rapexa/kmtouch/hardware/netlist.txt

# kmtouch v1 netlist, pin-level (generated from kicad/kmtouch.kicad_pcb; source of truth = kicad/kmtouch.kicad_sch)
+1V1: C11.1 C12.1 C13.1 U1.23 U1.45 U1.50
+3V3: C10.1 C16.1 C3.1 C4.1 C5.1 C6.1 C7.1 C8.1 C9.1 R12.2 R7.2 R8.2 U1.1 U1.10 U1.22 U1.33 U1.42 U1.43 U1.44 U1.48 U1.49 U2.5 U3.8
+5V: C1.1 C19.1 C2.1 C21.1 F1.2 U2.1 U2.3 U5.5 U6.18 U6.20
5V_A: C20.1 J2.1 J3.1 U5.1 U7.5 U8.5
A1DM: J2.2 U6.10 U7.3 U7.4
A1DP: J2.3 U6.11 U7.1 U7.6
A2DM: J3.2 U6.8 U8.3 U8.4
A2DP: J3.3 U6.9 U8.1 U8.6
BOOT: R9.2 SW1.1
CC1: J1.A5 R1.1
CC2: J1.B5 R2.1
CDM: J1.A7 J1.B7 R4.1 U4.3 U4.4
CDP: J1.A6 J1.B6 R3.1 U4.1 U4.6
FLT: R12.1 U1.30 U5.3 U6.26
GND: C1.2 C10.2 C11.2 C12.2 C13.2 C14.2 C15.2 C16.2 C17.2 C18.2 C19.2 C2.2 C20.2 C21.2 C3.2 C4.2 C5.2 C6.2 C7.2 C8.2 C9.2 D1.1 J1.A1 J1.A12 J1.B1 J1.B12 J1.S1 J2.4 J2.5 J3.4 J3.5 R1.2 R13.2 R15.2 R2.2 SW1.2 SW2.2 TP3.1 U1.19 U1.57 U2.2 U3.4 U4.2 U5.2 U6.1 U7.2 U8.2 Y1.2 Y1.4 Y2.2 Y2.4
GP2: R5.1 U1.4
GP25: R11.1 U1.37
GP3: R6.1 U1.5
HRST: R14.1 U6.17
HUB_DM: R6.2 U6.15
HUB_DP: R5.2 U6.16
HXI: U6.3 Y2.1
HXO: U6.2 Y2.3
LED_A: D1.2 R11.2
QSPI_SCLK: U1.52 U3.6
QSPI_SD0: U1.53 U3.5
QSPI_SD1: U1.55 U3.2
QSPI_SD2: U1.54 U3.3
QSPI_SD3: U1.51 U3.7
QSPI_SS: R8.1 R9.1 U1.56 U3.1
REXT: R13.1 U6.14
RUN: R7.1 SW2.1 U1.26
SWCLK: TP1.1 U1.24
SWDIO: TP2.1 U1.25
USB_DM: R4.2 U1.46
USB_DP: R3.2 U1.47
VBUS: F1.1 J1.A4 J1.A9 J1.B4 J1.B9 U4.5
VBUS_EN: R15.1 U1.29 U5.4
VD33H: C17.1 C18.1 R14.2 U6.13 U6.19 U6.21
XIN: C14.1 U1.20 Y1.1
XO1: C15.1 R10.2 Y1.3
XOUT: R10.1 U1.21
