rapexa/kmtouch/hardware/kicad/out/render/kmtouch_2d_bottom.png

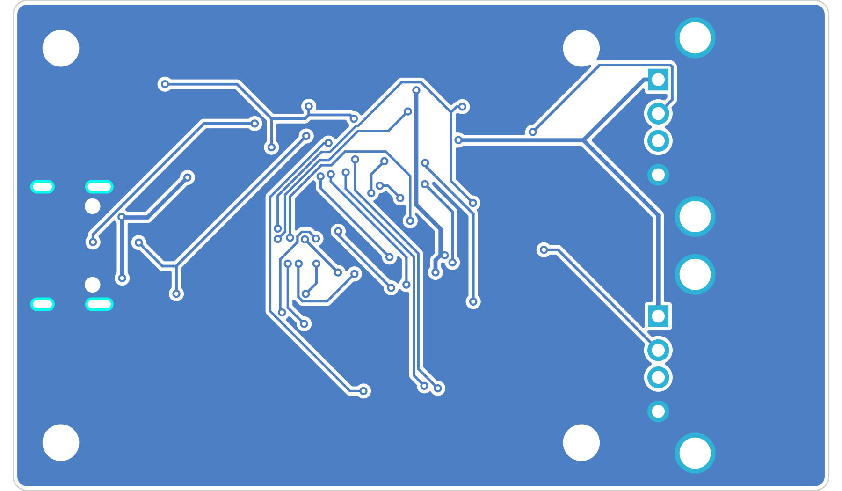
hardware/kicad/out/render/kmtouch_2d_bottom.png
