rapexa/kmtouch/hardware/kicad/out/render/kmtouch_3d_bottom.png

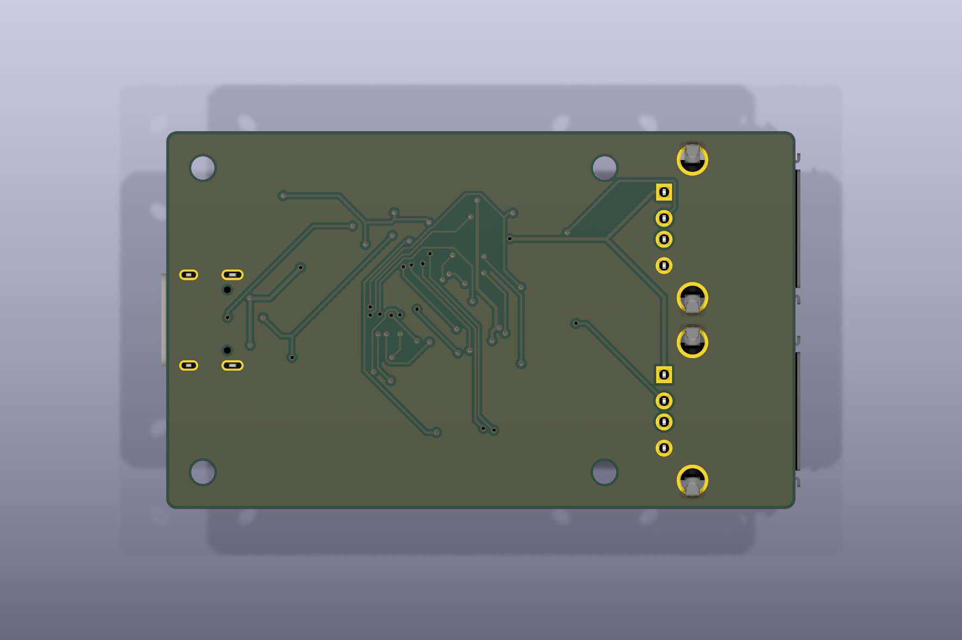
hardware/kicad/out/render/kmtouch_3d_bottom.png
