rapexa/kmtouch/hardware/kicad/out/render/kmtouch_3d_top.png

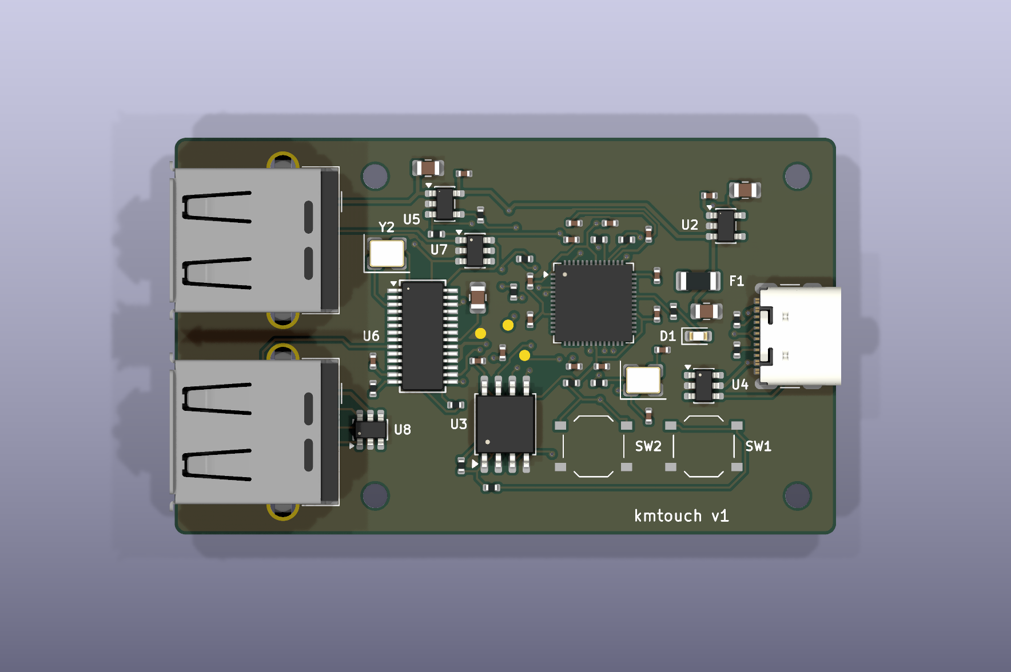
hardware/kicad/out/render/kmtouch_3d_top.png
