rapexa/kmtouch/hardware/kicad/out/render/kmtouch_schematic.png

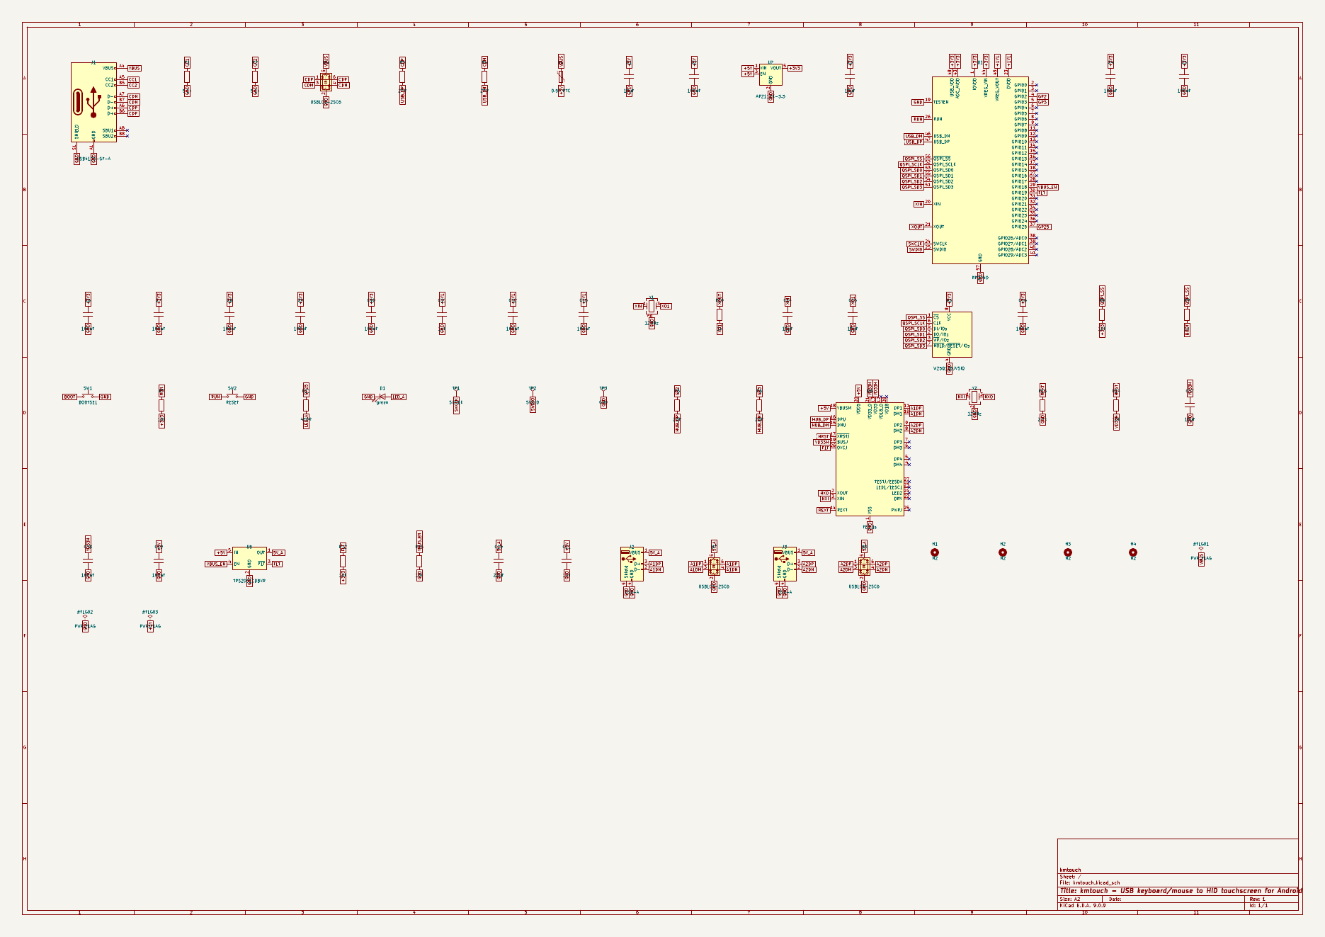
hardware/kicad/out/render/kmtouch_schematic.png
