rapexa/kmtouch/hardware/schematic.png

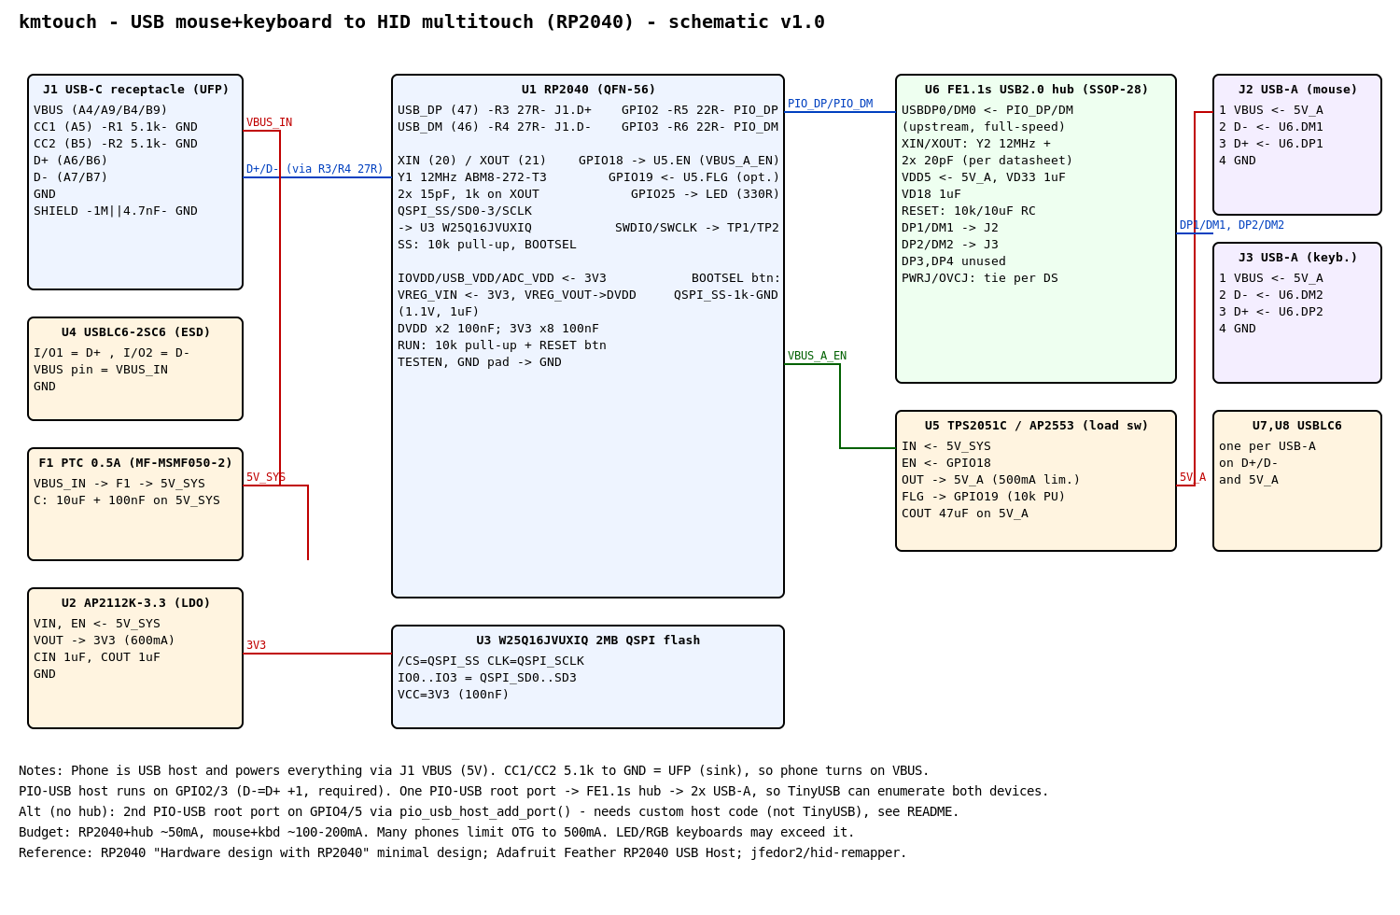
hardware/schematic.png
