rapexa/kmtouch/hardware/BOM.csv

Ref | Value | Footprint | LCSC
C1 | 10uF | Capacitor_SMD:C_0805_2012Metric | C15850
C10 | 100nF | Capacitor_SMD:C_0402_1005Metric | C1525
C11 | 1uF | Capacitor_SMD:C_0402_1005Metric | C52923
C12 | 100nF | Capacitor_SMD:C_0402_1005Metric | C1525
C13 | 100nF | Capacitor_SMD:C_0402_1005Metric | C1525
C14 | 15pF | Capacitor_SMD:C_0402_1005Metric | C1548
C15 | 15pF | Capacitor_SMD:C_0402_1005Metric | C1548
C16 | 100nF | Capacitor_SMD:C_0402_1005Metric | C1525
C17 | 10uF | Capacitor_SMD:C_0805_2012Metric | C15850
C18 | 100nF | Capacitor_SMD:C_0402_1005Metric | C1525
C19 | 100nF | Capacitor_SMD:C_0402_1005Metric | C1525
C2 | 100nF | Capacitor_SMD:C_0402_1005Metric | C1525
C20 | 22uF | Capacitor_SMD:C_0805_2012Metric | C45783
C21 | 1uF | Capacitor_SMD:C_0402_1005Metric | C52923
C3 | 10uF | Capacitor_SMD:C_0805_2012Metric | C15850
C4 | 100nF | Capacitor_SMD:C_0402_1005Metric | C1525
C5 | 100nF | Capacitor_SMD:C_0402_1005Metric | C1525
C6 | 100nF | Capacitor_SMD:C_0402_1005Metric | C1525
C7 | 100nF | Capacitor_SMD:C_0402_1005Metric | C1525
C8 | 100nF | Capacitor_SMD:C_0402_1005Metric | C1525
C9 | 100nF | Capacitor_SMD:C_0402_1005Metric | C1525
D1 | green | LED_SMD:LED_0603_1608Metric | C72043
F1 | 0.5A PTC | Fuse:Fuse_1206_3216Metric | C70076
H1 | M2 | MountingHole:MountingHole_2.2mm_M2
H2 | M2 | MountingHole:MountingHole_2.2mm_M2
H3 | M2 | MountingHole:MountingHole_2.2mm_M2
H4 | M2 | MountingHole:MountingHole_2.2mm_M2
J1 | USB4105-GF-A | Connector_USB:USB_C_Receptacle_GCT_USB4105-xx-A_16P_TopMnt_Horizontal | C3020560
J2 | USB-A | Connector_USB:USB_A_Molex_67643_Horizontal | C19170946
J3 | USB-A | Connector_USB:USB_A_Molex_67643_Horizontal | C19170946
R1 | 5.1k | Resistor_SMD:R_0402_1005Metric | C25905
R10 | 1k | Resistor_SMD:R_0402_1005Metric | C11702
R11 | 470R | Resistor_SMD:R_0402_1005Metric | C25117
R12 | 10k | Resistor_SMD:R_0402_1005Metric | C25744
R13 | 2.7k | Resistor_SMD:R_0402_1005Metric | C284470
R14 | 10k | Resistor_SMD:R_0402_1005Metric | C25744
R15 | 10k | Resistor_SMD:R_0402_1005Metric | C25744
R2 | 5.1k | Resistor_SMD:R_0402_1005Metric | C25905
R3 | 27R | Resistor_SMD:R_0402_1005Metric | C25100
R4 | 27R | Resistor_SMD:R_0402_1005Metric | C25100
R5 | 22R | Resistor_SMD:R_0402_1005Metric | C25092
R6 | 22R | Resistor_SMD:R_0402_1005Metric | C25092
R7 | 10k | Resistor_SMD:R_0402_1005Metric | C25744
R8 | 10k | Resistor_SMD:R_0402_1005Metric | C25744
R9 | 1k | Resistor_SMD:R_0402_1005Metric | C11702
SW1 | BOOTSEL | Button_Switch_SMD:SW_Push_1P1T_XKB_TS-1187A | C318884
SW2 | RESET | Button_Switch_SMD:SW_Push_1P1T_XKB_TS-1187A | C318884
TP1 | SWCLK | TestPoint:TestPoint_Pad_D1.0mm
TP2 | SWDIO | TestPoint:TestPoint_Pad_D1.0mm
TP3 | GND | TestPoint:TestPoint_Pad_D1.0mm
U1 | RP2040 | Package_DFN_QFN:QFN-56-1EP_7x7mm_P0.4mm_EP3.2x3.2mm | C2040
U2 | AP2112K-3.3 | Package_TO_SOT_SMD:SOT-23-5 | C51118
U3 | W25Q128JVSIQ | Package_SO:SOIC-8_5.3x5.3mm_P1.27mm | C97521
U4 | USBLC6-2SC6 | Package_TO_SOT_SMD:SOT-23-6 | C7519
U5 | TPS2051CDBVR | Package_TO_SOT_SMD:SOT-23-5 | C129581
U6 | FE1.1s | Package_SO:SSOP-28_3.9x9.9mm_P0.635mm | C9359
U7 | USBLC6-2SC6 | Package_TO_SOT_SMD:SOT-23-6 | C7519
U8 | USBLC6-2SC6 | Package_TO_SOT_SMD:SOT-23-6 | C7519
Y1 | 12MHz | Crystal:Crystal_SMD_3225-4Pin_3.2x2.5mm | C9002
Y2 | 12MHz | Crystal:Crystal_SMD_3225-4Pin_3.2x2.5mm | C9002
