rapexa/kmtouch/case/kmtouch_case_base.stl

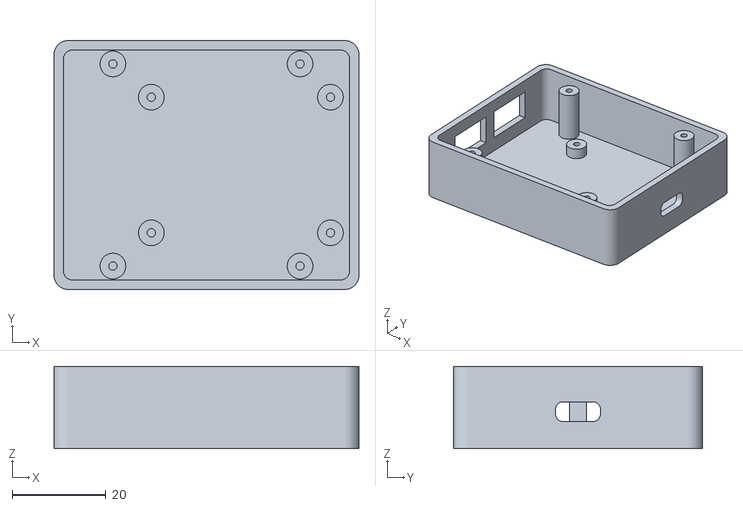
[picture p9: CAD file, 2026-10-30]
case/kmtouch_case_base.stl
65.2 x 53.2 x 17.6
