rapexa/kmtouch/case/kmtouch_case_lid.stl

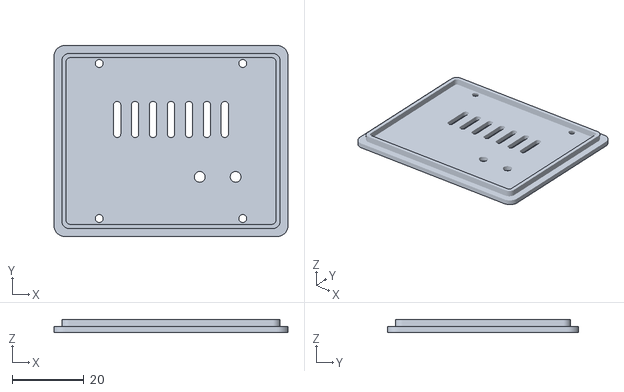
[picture p10: CAD file, 2026-10-30]
case/kmtouch_case_lid.stl
65.2 x 53.2 x 3.60
