rapexa/kmtouch/case/kmtouch_case_both.stl

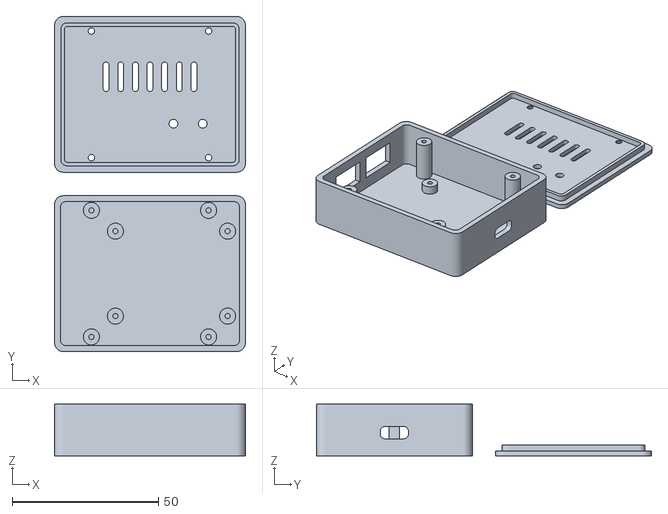
[picture p11: CAD file, 2026-10-30]
case/kmtouch_case_both.stl
65.2 x 114.4 x 17.6
