rapexa/kmtouch/case/preview_print_layout.png

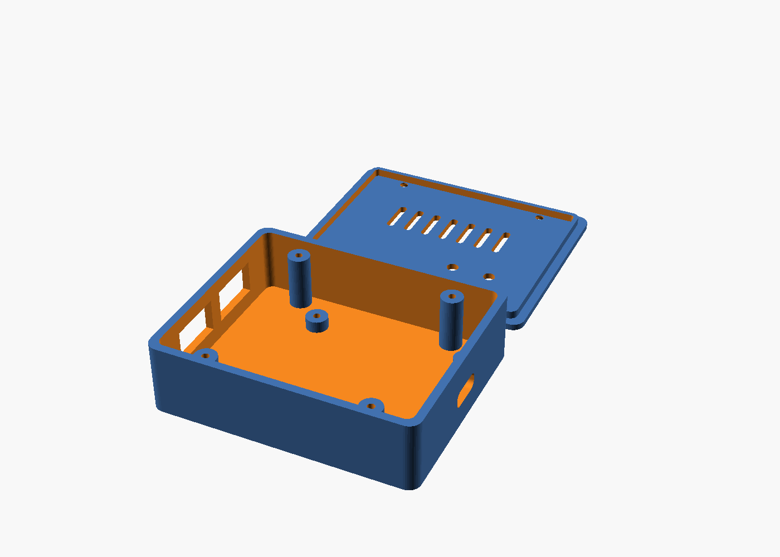
case/preview_print_layout.png
