rapexa/kmtouch/hardware/kicad/out/kmtouch_schematic.pdf

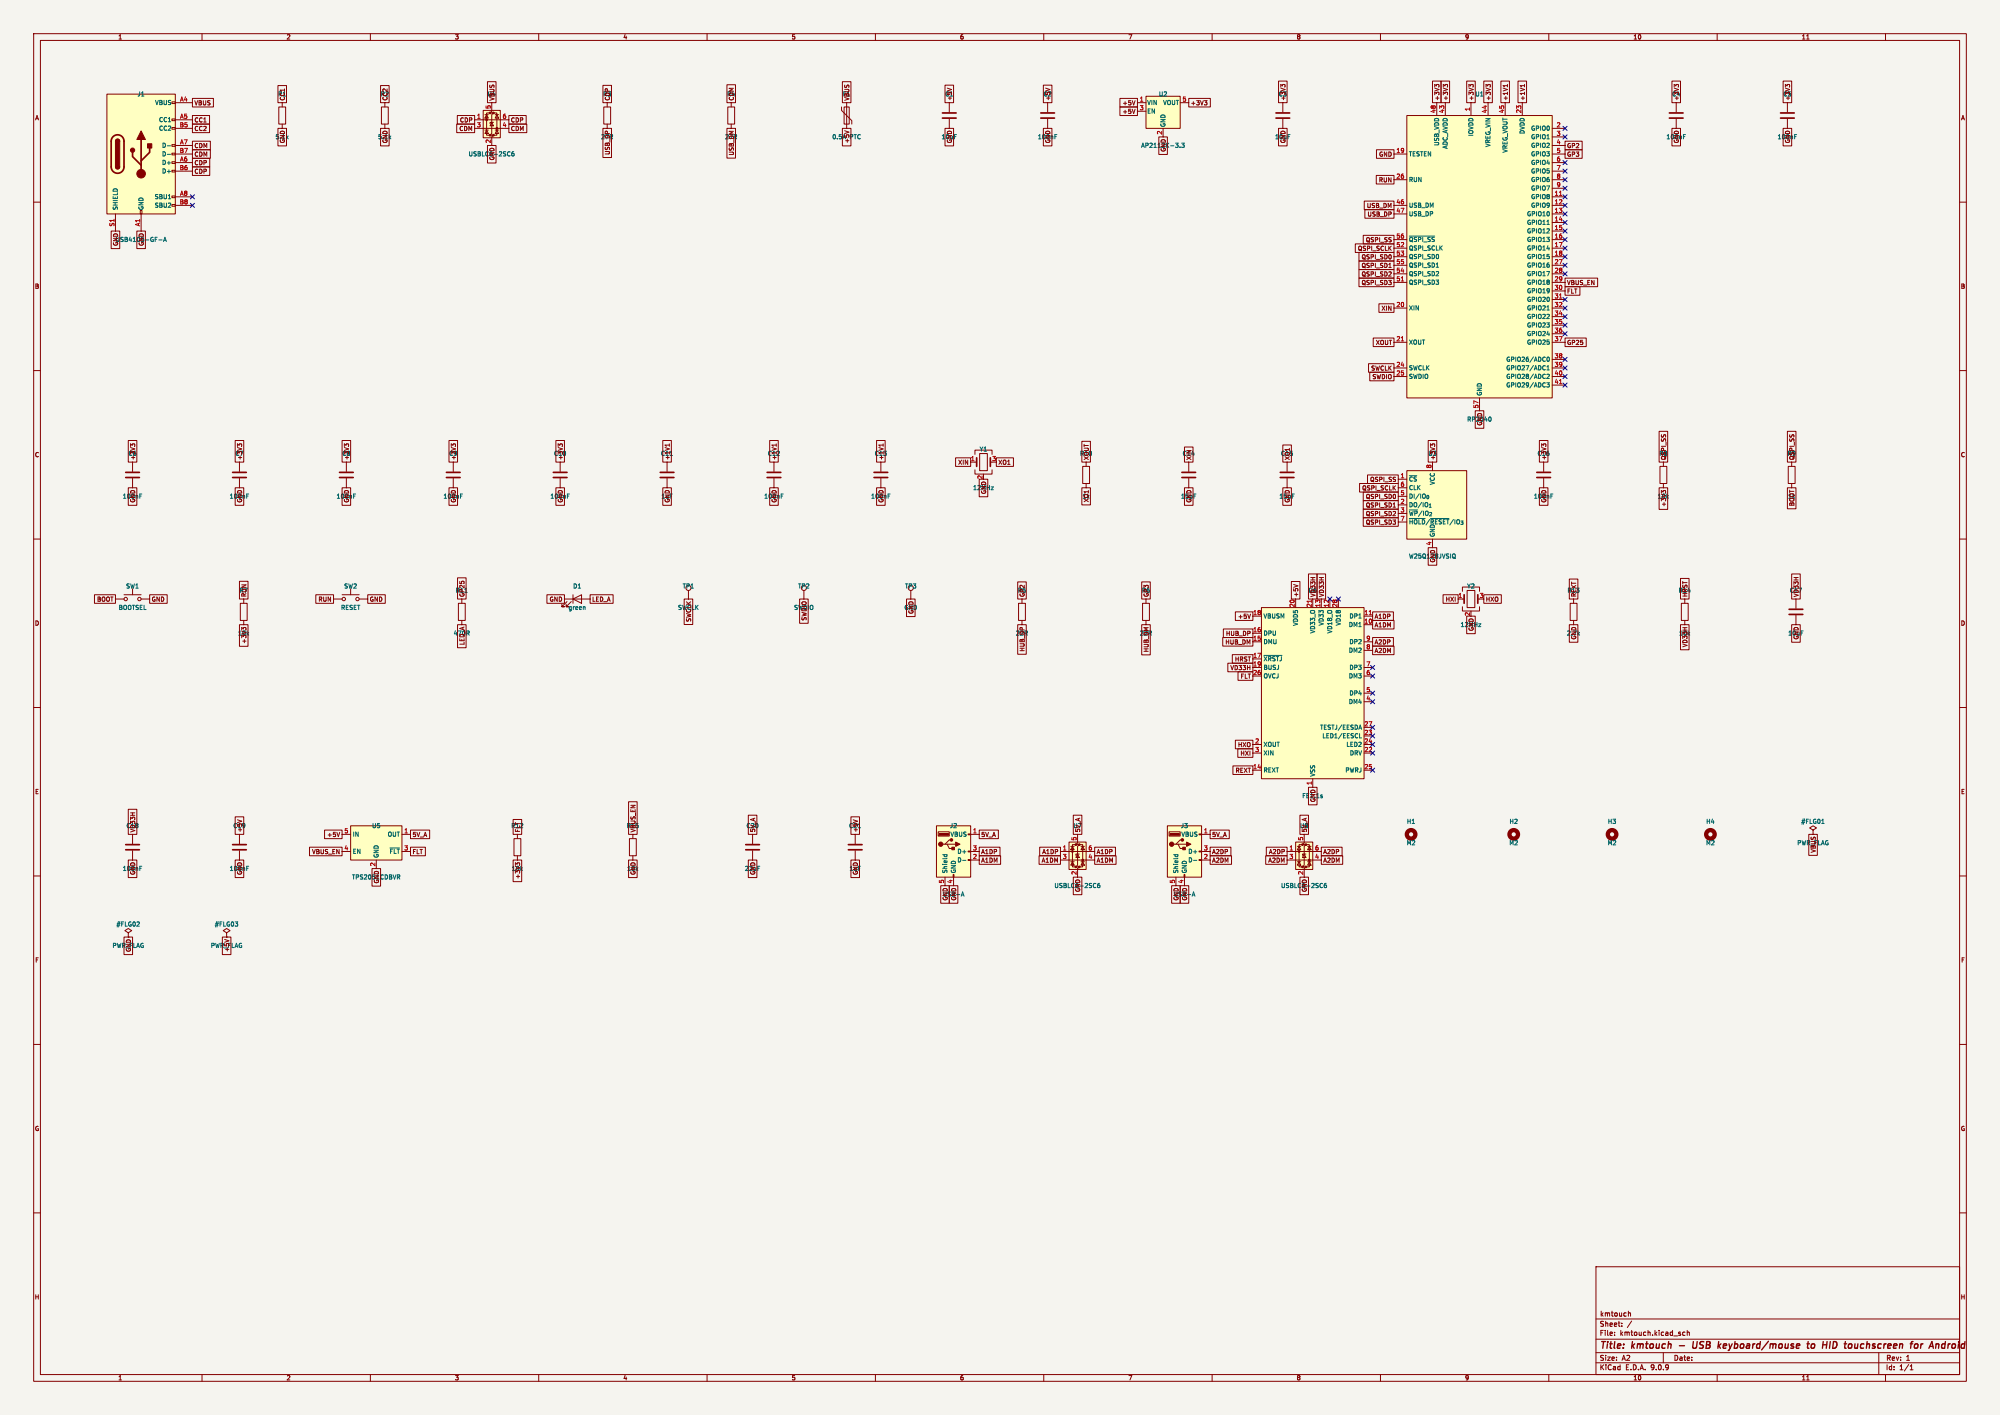
[picture p13: page 1]

File: kmtouch.kicad_sch Sheet: / kmtouch
