rapexa/kmtouch/hardware/kicad/kmtouch.kicad_pcb

## KiCad design hardware/kicad/kmtouch.kicad_pcb (2026-10-30)

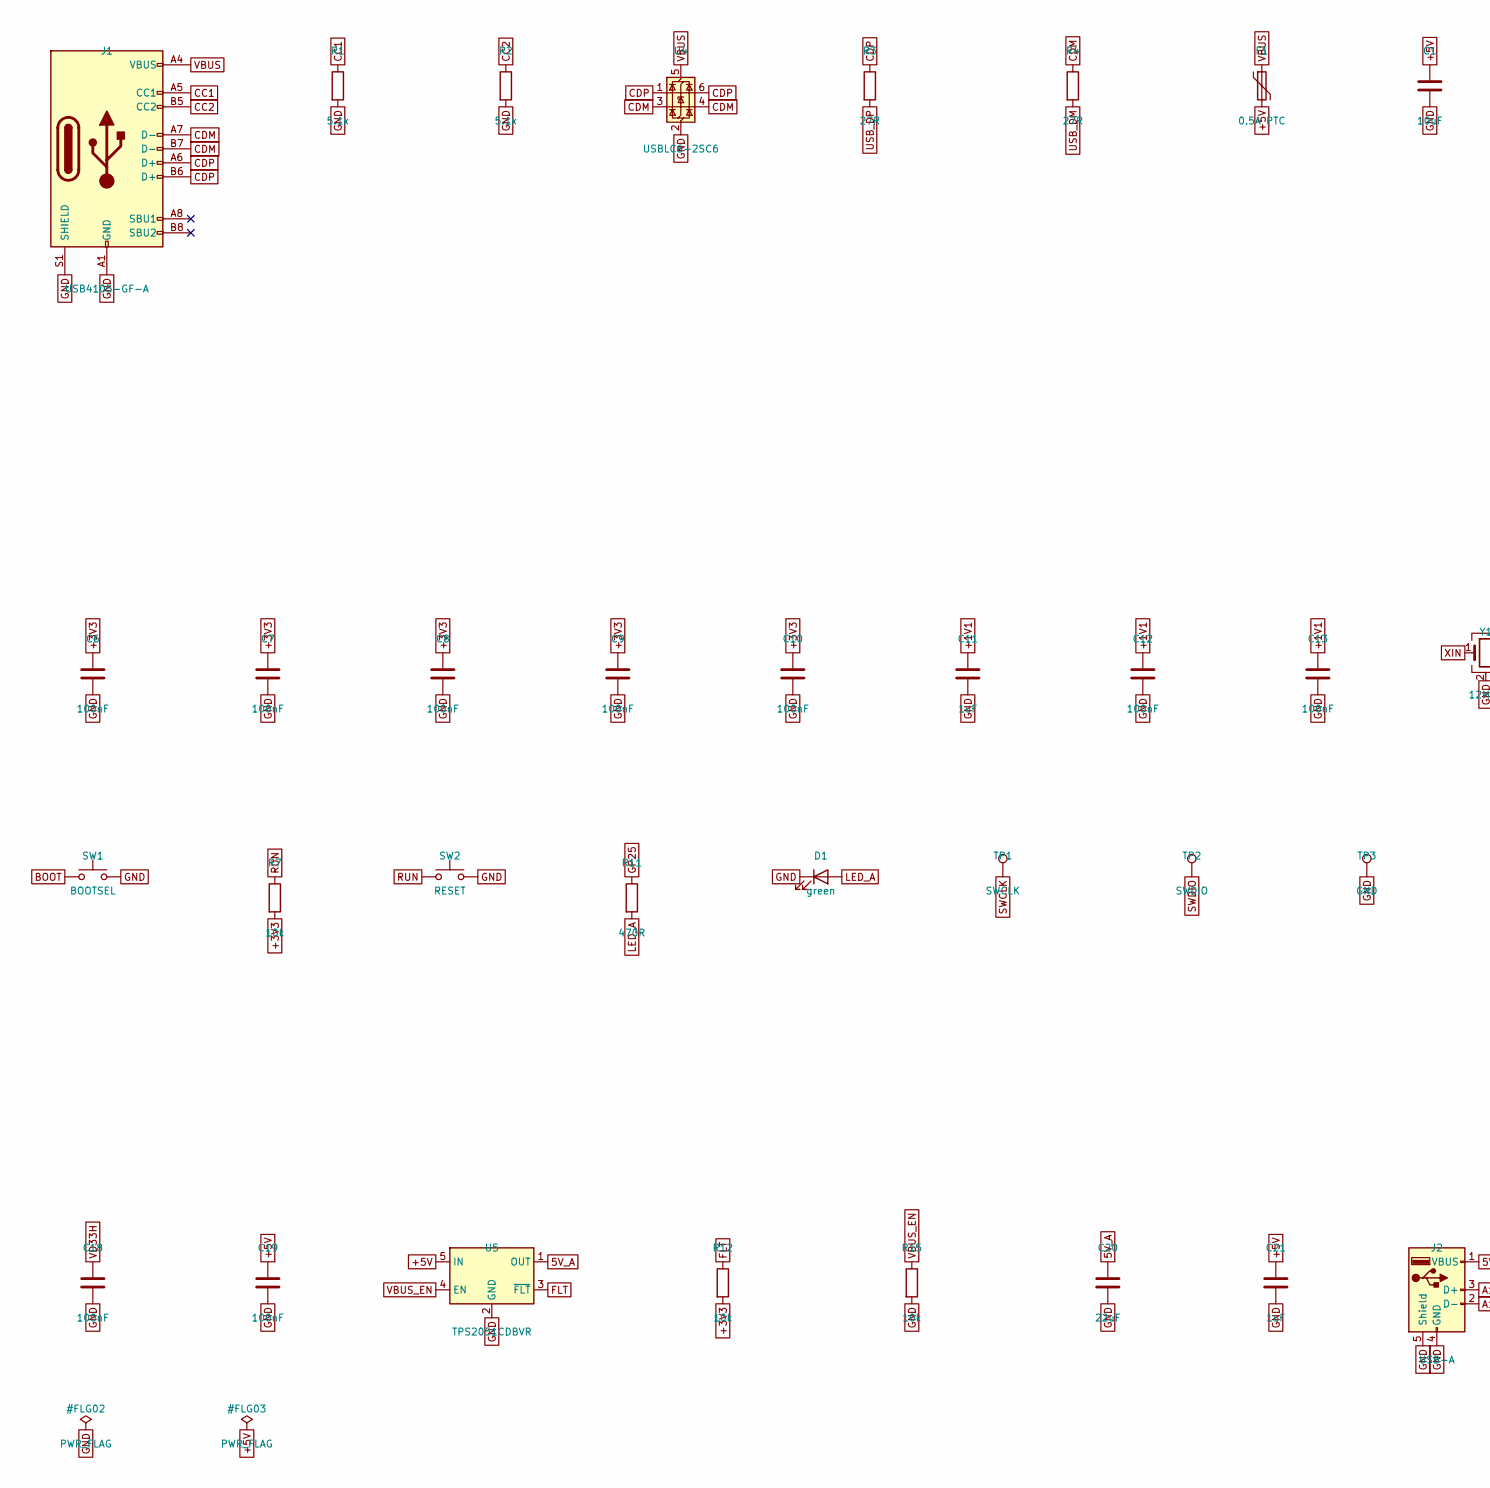
[picture p14: schematic kmtouch.kicad_sch, kmtouch - USB keyboard/mouse to HID touchscreen for Android, part in row 1, column 1]

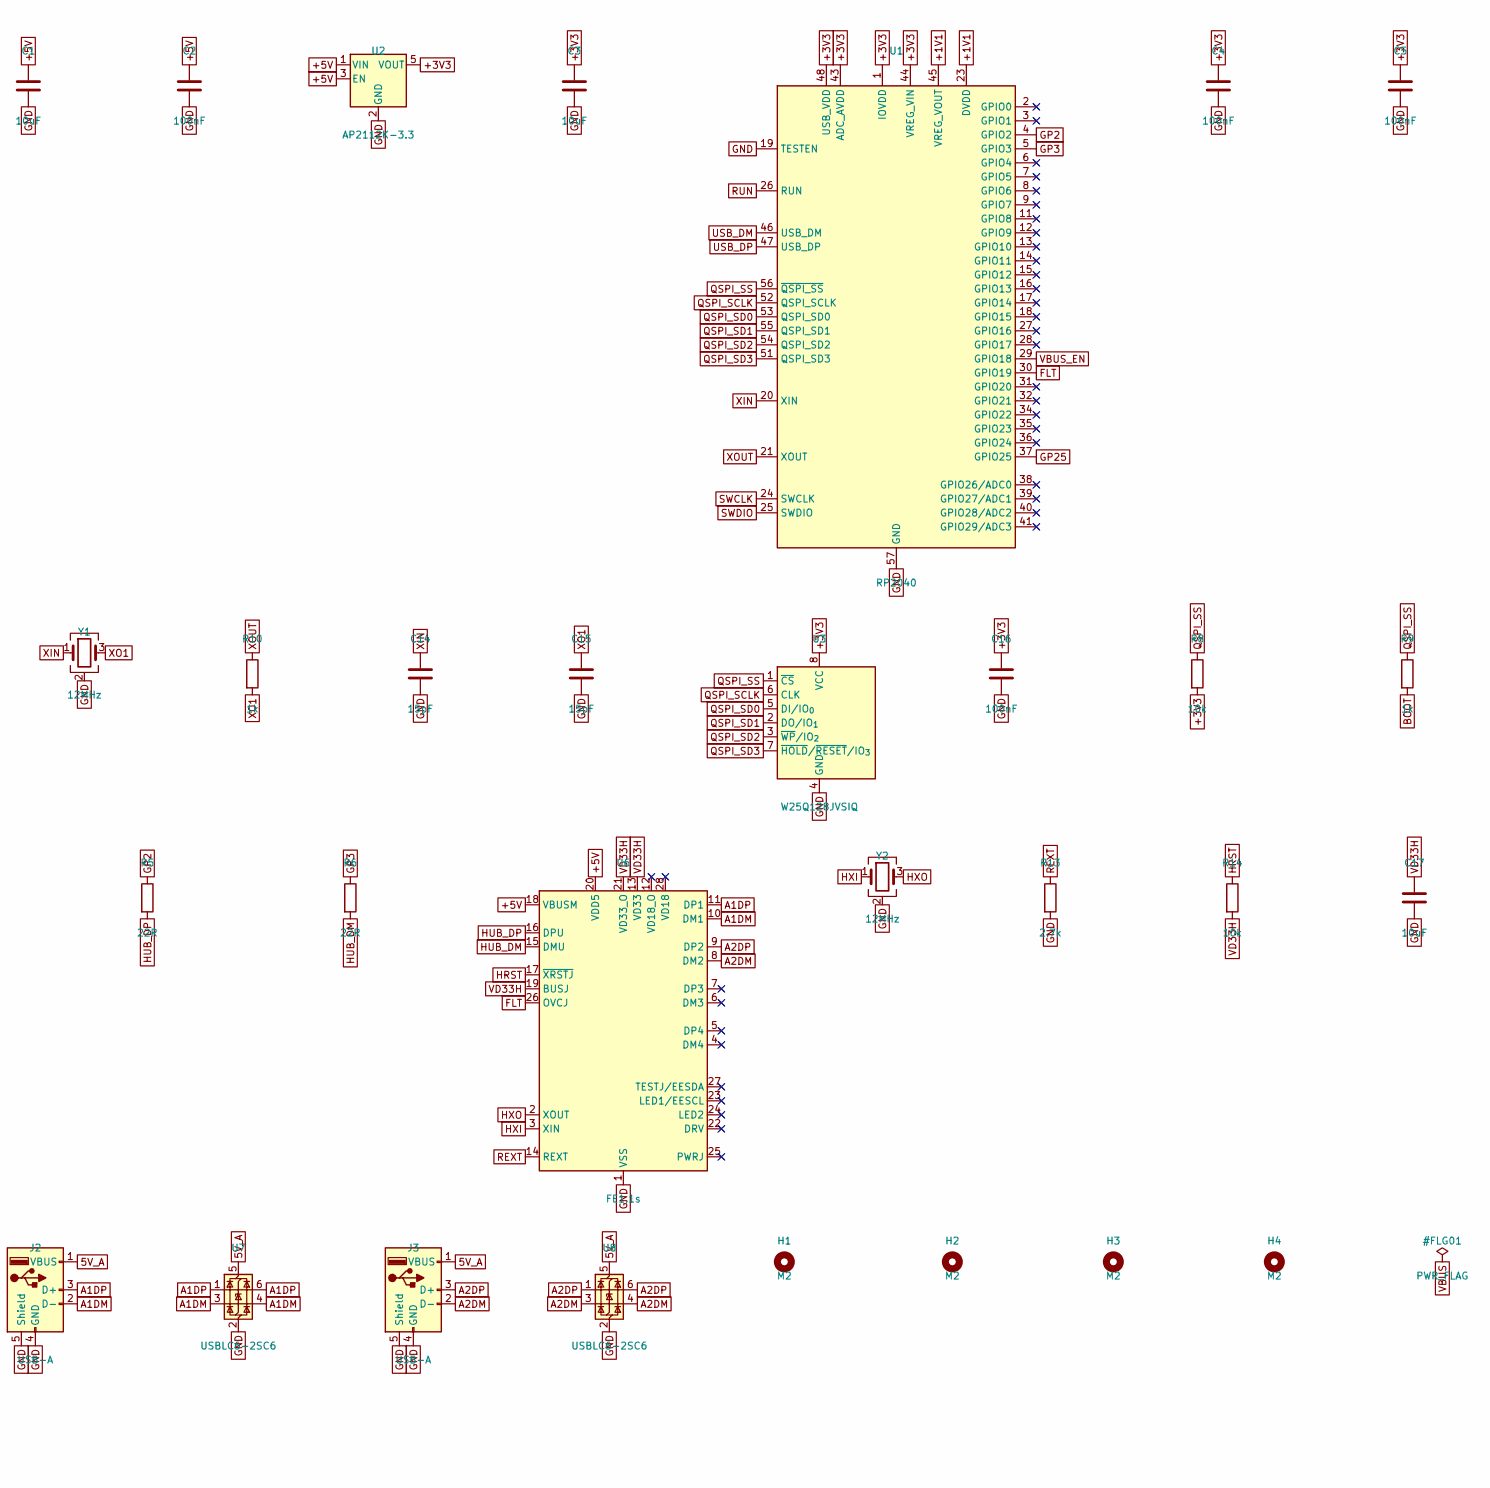
[picture p15: schematic kmtouch.kicad_sch, kmtouch - USB keyboard/mouse to HID touchscreen for Android, part in row 1, column 2]

Parts:
C1, C3, C17: 10uF; C_0805_2012Metric; LCSC C15850
C2, C4, C5, C6, C7, C8, C9, C10, C12, C13, C16, C18, C19: 100nF; C_0402_1005Metric; LCSC C1525
C11, C21: 1uF; C_0402_1005Metric; LCSC C52923
C14, C15: 15pF; C_0402_1005Metric; LCSC C1548
C20: 22uF; C_0805_2012Metric; LCSC C45783
D1: green; LED_0603_1608Metric; LCSC C72043
F1: 0.5A PTC; Fuse_1206_3216Metric; LCSC C70076
H1, H2, H3, H4: M2; MountingHole_2.2mm_M2
J1: USB4105-GF-A; USB_C_Receptacle_GCT_USB4105-xx-A_16P_TopMnt_Horizontal; LCSC C3020560
J2, J3: USB-A; USB_A_Molex_67643_Horizontal; LCSC C19170946
R1, R2: 5.1k; R_0402_1005Metric; LCSC C25905
R3, R4: 27R; R_0402_1005Metric; LCSC C25100
R5, R6: 22R; R_0402_1005Metric; LCSC C25092
R7, R8, R12, R14, R15: 10k; R_0402_1005Metric; LCSC C25744
R9, R10: 1k; R_0402_1005Metric; LCSC C11702
R11: 470R; R_0402_1005Metric; LCSC C25117
R13: 2.7k; R_0402_1005Metric; LCSC C284470
SW1: BOOTSEL; SW_Push_1P1T_XKB_TS-1187A; LCSC C318884
SW2: RESET; SW_Push_1P1T_XKB_TS-1187A; LCSC C318884
TP1: SWCLK; TestPoint_Pad_D1.0mm
TP2: SWDIO; TestPoint_Pad_D1.0mm
TP3: GND; TestPoint_Pad_D1.0mm
U1: RP2040; QFN-56-1EP_7x7mm_P0.4mm_EP3.2x3.2mm; LCSC C2040
U2: AP2112K-3.3; SOT-23-5; LCSC C51118
U3: W25Q128JVSIQ; SOIC-8_5.3x5.3mm_P1.27mm; LCSC C97521
U4, U7, U8: USBLC6-2SC6; SOT-23-6; LCSC C7519
U5: TPS2051CDBVR; SOT-23-5; LCSC C129581
U6: FE1.1s; SSOP-28_3.9x9.9mm_P0.635mm; LCSC C9359
Y1, Y2: 12MHz; Crystal_SMD_3225-4Pin_3.2x2.5mm; LCSC C9002

Connections:
5V_A: C20.1, J2.1 (VBUS), J3.1 (VBUS), U5.1 (OUT), U7.5 (VBUS), U8.5 (VBUS)
+1V1: C11.1, C12.1, C13.1, U1.23 (DVDD), U1.45 (VREG_VOUT), U1.50 (DVDD)
+3V3: C3.1, C4.1, C5.1, C6.1, C7.1, C8.1, C9.1, C10.1, C16.1, R7.2, R8.2, R12.2, U1.1 (IOVDD), U1.10 (IOVDD), U1.22 (IOVDD), U1.33 (IOVDD), U1.42 (IOVDD), U1.43 (ADC_AVDD), U1.44 (VREG_VIN), U1.48 (USB_VDD), U1.49 (IOVDD), U2.5 (VOUT), U3.8 (VCC)
+5V: C1.1, C2.1, C19.1, C21.1, F1.2, U2.1 (VIN), U2.3 (EN), U5.5 (IN), U6.18 (VBUSM), U6.20 (VDD5)
A1DM: J2.2 (D-), U6.10 (DM1), U7.3 (I/O2), U7.4 (I/O2)
A1DP: J2.3 (D+), U6.11 (DP1), U7.1 (I/O1), U7.6 (I/O1)
A2DM: J3.2 (D-), U6.8 (DM2), U8.3 (I/O2), U8.4 (I/O2)
A2DP: J3.3 (D+), U6.9 (DP2), U8.1 (I/O1), U8.6 (I/O1)
BOOT: R9.2, SW1.1
CC1: J1.A5 (CC1), R1.1
CC2: J1.B5 (CC2), R2.1
CDM: J1.A7 (D-), J1.B7 (D-), R4.1, U4.3 (I/O2), U4.4 (I/O2)
CDP: J1.A6 (D+), J1.B6 (D+), R3.1, U4.1 (I/O1), U4.6 (I/O1)
FLT: R12.1, U1.30 (GPIO19), U5.3 (~FLT), U6.26 (OVCJ)
GND: C1.2, C2.2, C3.2, C4.2, C5.2, C6.2, C7.2, C8.2, C9.2, C10.2, C11.2, C12.2, C13.2, C14.2, C15.2, C16.2, C17.2, C18.2, C19.2, C20.2, C21.2, D1.1 (K), J1.A1 (GND), J1.A12 (GND), J1.B1 (GND), J1.B12 (GND), J1.S1 (SHIELD), J2.4 (GND), J2.5 (Shield), J3.4 (GND), J3.5 (Shield), R1.2, R2.2, R13.2, R15.2, SW1.2, SW2.2, TP3.1, U1.19 (TESTEN), U1.57 (GND), U2.2 (GND), U3.4 (GND), U4.2 (GND), U5.2 (GND), U6.1 (VSS), U7.2 (GND), U8.2 (GND), Y1.2 (G), Y1.4 (G), Y2.2 (G), Y2.4 (G)
GP2: R5.1, U1.4 (GPIO2)
GP3: R6.1, U1.5 (GPIO3)
GP25: R11.1, U1.37 (GPIO25)
HRST: R14.1, U6.17 (~XRSTJ)
HUB_DM: R6.2, U6.15 (DMU)
HUB_DP: R5.2, U6.16 (DPU)
HXI: U6.3 (XIN), Y2.1
HXO: U6.2 (XOUT), Y2.3
LED_A: D1.2 (A), R11.2
QSPI_SCLK: U1.52 (QSPI_SCLK), U3.6 (CLK)
QSPI_SD0: U1.53 (QSPI_SD0), U3.5 (DI/IO_{0})
QSPI_SD1: U1.55 (QSPI_SD1), U3.2 (DO/IO_{1})
QSPI_SD2: U1.54 (QSPI_SD2), U3.3 (~WP/IO_{2})
QSPI_SD3: U1.51 (QSPI_SD3), U3.7 (~HOLD/~RESET/IO_{3})
QSPI_SS: R8.1, R9.1, U1.56 (~QSPI_SS), U3.1 (~CS)
REXT: R13.1, U6.14 (REXT)
RUN: R7.1, SW2.1, U1.26 (RUN)
SWCLK: TP1.1, U1.24 (SWCLK)
SWDIO: TP2.1, U1.25 (SWDIO)
USB_DM: R4.2, U1.46 (USB_DM)
USB_DP: R3.2, U1.47 (USB_DP)
VBUS: F1.1, J1.A4 (VBUS), J1.A9 (VBUS), J1.B4 (VBUS), J1.B9 (VBUS), U4.5 (VBUS)
VBUS_EN: R15.1, U1.29 (GPIO18), U5.4 (EN)
VD33H: C17.1, C18.1, R14.2, U6.13 (VD33), U6.19 (BUSJ), U6.21 (VD33_O)
XIN: C14.1, U1.20 (XIN), Y1.1
XO1: C15.1, R10.2, Y1.3
XOUT: R10.1, U1.21 (XOUT)

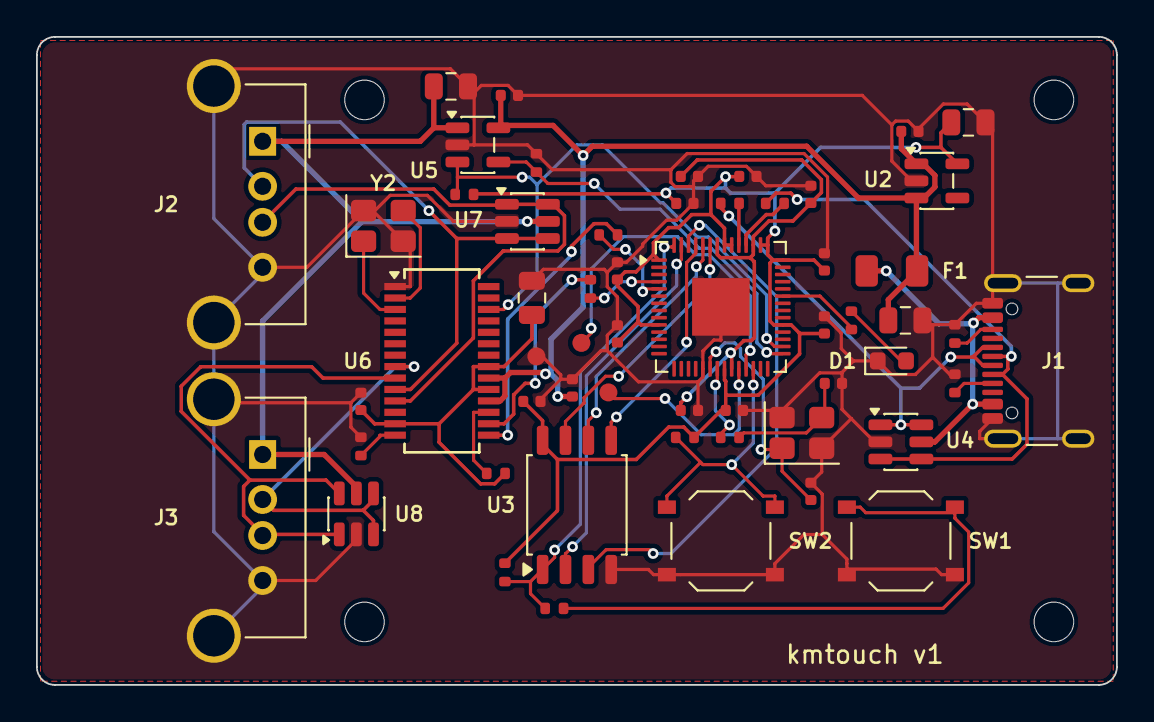
[picture p16: board kmtouch.kicad_pcb from above]

Board: 2 copper layers, 60.0 x 36.0 mm, 60 parts (0 on the bottom side), 42 nets.
